joshajohnson/mini4wd-motor-tester/hardware/0.2/mini4wd-motor-tester.kicad_pcb

## KiCad design hardware/0.2/mini4wd-motor-tester.kicad_pcb (2026-05-05)

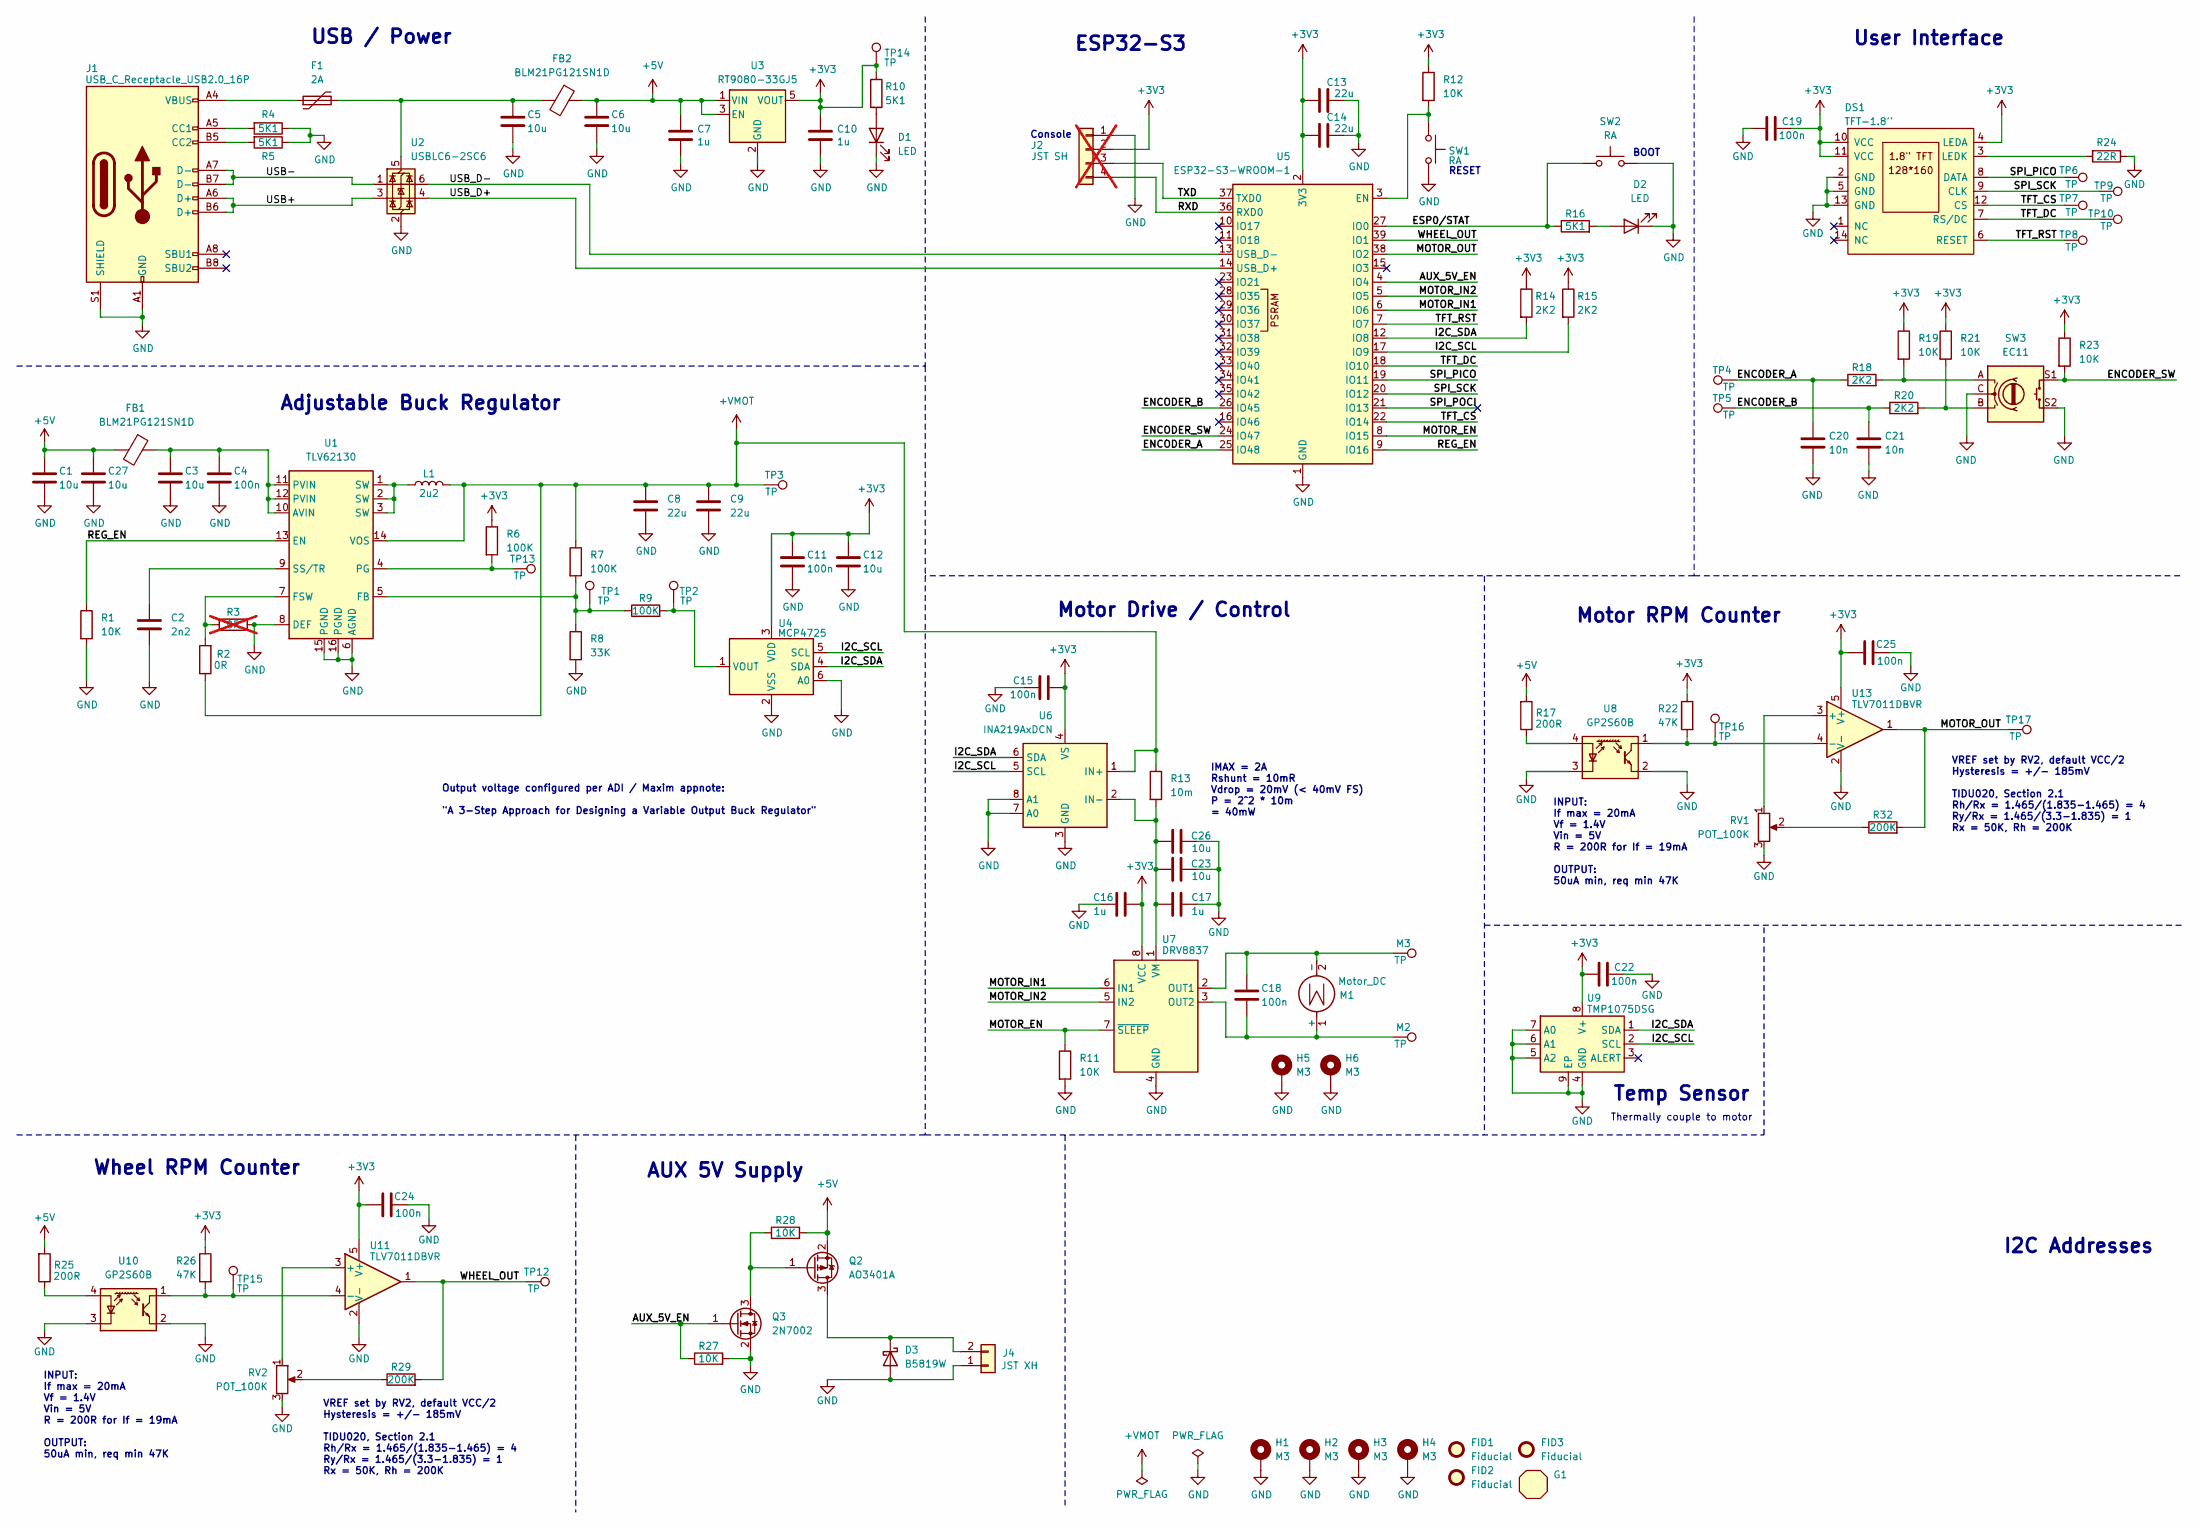
[picture p1: schematic mini4wd-motor-tester.kicad_sch, Mini4WD Motor Tester]

Parts:
C1, C3, C5, C6, C12, C23, C26, C27: 10u; C_0805_2012Metric; MPN GRM21BR61H106KE43L; LCSC C440198
C2: 2n2; C_0603_1608Metric; MPN 0603B222K500NT; LCSC C1604
C4, C11, C15, C18, C19, C22, C24, C25: 100n; C_0603_1608Metric; MPN CC0603KRX7R9BB104; LCSC C14663
C7, C10, C16, C17: 1u; C_0603_1608Metric; MPN CL10A105KB8NNNC; LCSC C15849
C8, C9, C13, C14: 22u; C_1206_3216Metric; MPN CL31A226KAHNNNE; LCSC C12891
C20, C21: 10n; C_0603_1608Metric; MPN 0603B103K500NT; LCSC C57112
D1, D2: LED; LED_0603_1608Metric; MPN KT-0603R; LCSC C2286
D3: B5819W; D_SOD-123; MPN B5819W SL; LCSC C8598
DS1: TFT-1.8''; 1.8TFT; MPN N177-1216TCWPG01-H14; LCSC C5123575
F1: 2A; Fuse_1206_3216Metric; MPN NANOSMDC200F-2; LCSC C2153712
FB1, FB2: BLM21PG121SN1D; L_0805_2012Metric; MPN BLM21PG121SN1D; LCSC C79382
FID1, FID2, FID3: Fiducial; Fiducial_1mm_Mask3mm
G1: josh-details
H1, H2, H3, H4, H5, H6: M3; MountingHole_3.2mm_M3_DIN965_Pad_TopBottom
J1: USB_C_Receptacle_USB2.0_16P; USB_C_Receptacle_HRO_TYPE-C-31-M-12; MPN TYPE-C-31-M-12; LCSC C165948
J2: JST SH; JST_SH_SM04B-SRSS-TB_1x04-1MP_P1.00mm_Horizontal; MPN SM04B-SRSS-TB(LF)(SN); LCSC C160404; not fitted
J4: JST XH; JST_XH_S2B-XH-A_1x02_P2.50mm_Horizontal; MPN S2B-XH-A(LF)(SN); LCSC C157931
L1: 2u2; L_Vishay_IHLP-1616; MPN PSPMAA0402-2R2M-ANP; LCSC C436515
M1: Motor_DC; Mini4WD_Motor
M2, M3: TP; TestPoint_THTPad_D1.5mm_Drill0.7mm
Q2: AO3401A; SOT-23; MPN AO3401A; LCSC C15127
Q3: 2N7002; SOT-23; MPN 2N7002; LCSC C8545
R1, R11, R12, R19, R21, R23, R27, R28: 10K; R_0603_1608Metric; MPN 0603WAF1002T5E; LCSC C25804
R2: 0R; R_0603_1608Metric; MPN 0603WAF0000T5E; LCSC C21189
R3: 0R; R_0603_1608Metric; MPN 0603WAF0000T5E; LCSC C21189; not fitted
R4, R5, R10, R16: 5K1; R_0603_1608Metric; MPN 0603WAF5101T5E; LCSC C23186
R6, R7, R9: 100K; R_0603_1608Metric; MPN 0603WAF1003T5E; LCSC C25803
R8: 33K; R_0603_1608Metric; MPN 0603WAF3302T5E; LCSC C4216
R13: 10m; R_1206_3216Metric; MPN CSR1206FT10L0; LCSC C346769
R14, R15, R18, R20: 2K2; R_0603_1608Metric; MPN 0603WAF2201T5E; LCSC C4190
R17, R25: 200R; R_0603_1608Metric; MPN 0603WAF2000T5E; LCSC C8218
R22, R26: 47K; R_0603_1608Metric; MPN 0603WAF4702T5E; LCSC C25819
R24: 22R; R_0603_1608Metric; MPN 0603WAF220JT5E; LCSC C23345
R29, R32: 200K; R_0603_1608Metric; MPN 0603WAF2003T5E; LCSC C25811
RV1, RV2: POT_100K; Potentiometer_Bourns_TC33X_Vertical; MPN TC33X-2-104E; LCSC C719186
SW1, SW2: RA; SW_PUSH_EVQPUL_EVQPUC; MPN TS-1186D-C-A; LCSC C397351
SW3: EC11; RotaryEncoder_Alps_EC11E_15MM; MPN PEC11R-4215F-S0024; LCSC C143790
TP1, TP2, TP3, TP4, TP5, TP6, TP7, TP8, TP9, TP10, TP12, TP13, TP14, TP15, TP16, TP17: TP; TestPoint_Pad_D1.0mm
U1: TLV62130; VQFN-16-1EP_3x3mm_P0.5mm_EP1.68x1.68mm; MPN TLV62130RGTR; LCSC C122479
U2: USBLC6-2SC6; SOT-23-6; MPN USBLC6-2SC6; LCSC C7519
U3: RT9080-33GJ5; SOT-23-5; MPN RT9080-33GJ5; LCSC C841192
U4: MCP4725; SOT-23-6; MPN MCP4725A0T-E/CH; LCSC C144198
U5: ESP32-S3-WROOM-1; MPN ESP32-S3-WROOM-1-N16R2; LCSC C2913205
U6: INA219AxDCN; SOT-23-8; MPN INA219AIDCNR; LCSC C87469
U7: DRV8837; WSON-8-1EP_2x2mm_P0.5mm_EP0.9x1.6mm; MPN DRV8837DSGR; LCSC C39159
U8, U10: GP2S60B; Sharp_GP2S60B; MPN GP2S60B; LCSC C83485
U9: TMP1075DSG; WSON-8-1EP_2x2mm_P0.5mm_EP0.9x1.6mm; MPN TMP1075DSGR; LCSC C2870250
U11, U13: TLV7011DBVR; SOT-23-5; MPN TLV7011DBVR; LCSC C702117

Connections:
+3V3: C10.2, C11.1, C12.1, C13.2, C14.2, C15.2, C16.1, C19.1, C22.2, C24.1, C25.1, DS1.4 (LEDA), DS1.10 (VCC), DS1.11 (VCC), J2.2, R6.1, R10.1, R12.1, R14.1, R15.1, R19.1, R21.1, R22.1, R23.1, R26.1, TP14.1, U3.5 (VOUT), U4.3 (VDD), U5.2 (3V3), U6.4 (VS), U7.8 (VCC), U9.8 (V+), U11.5 (V+), U13.5 (V+)
+5V: C1.1, C6.1, C7.2, C27.1, FB1.2, FB2.1, Q2.2 (S), R17.2, R25.2, R28.2, U3.1 (VIN), U3.3 (EN)
+VMOT: C8.1, C9.1, L1.2, R2.1, R7.1, R13.1, TP3.1, U1.14 (VOS), U6.1 (IN+)
/AUX_5V_EN: Q3.1 (G), R27.1, U5.4 (IO4)
/ENCODER_A: C20.1, R18.1, TP4.1, U5.25 (IO48)
/ENCODER_B: C21.1, R20.1, TP5.1, U5.26 (IO45)
/ENCODER_SW: R23.2, SW3.S1, U5.24 (IO47)
/ESP0/STAT: R16.1, SW2.1, U5.27 (IO0)
/I2C_SCL: R15.2, U4.5 (SCL), U5.17 (IO9), U6.5 (SCL), U9.2 (SCL)
/I2C_SDA: R14.2, U4.4 (SDA), U5.12 (IO8), U6.6 (SDA), U9.1 (SDA)
/MOTOR_EN: R11.1, U5.8 (IO15), U7.7 (~SLEEP)
/MOTOR_IN1: U5.6 (IO6), U7.6 (IN1)
/MOTOR_IN2: U5.5 (IO5), U7.5 (IN2)
/MOTOR_OUT: R32.2, TP17.1, U5.38 (IO2), U13.1
/REG_EN: R1.1, U1.13 (EN), U5.9 (IO16)
/RXD: J2.4, U5.36 (RXD0)
/SPI_PICO: DS1.8 (DATA), TP6.1, U5.19 (IO11)
/SPI_POCI: U5.21 (IO13)
/SPI_SCK: DS1.9 (CLK), TP9.1, U5.20 (IO12)
/TFT_CS: DS1.12 (CS), TP7.1, U5.22 (IO14)
/TFT_DC: DS1.7 (RS/DC), TP10.1, U5.18 (IO10)
/TFT_RST: DS1.6 (RESET), TP8.1, U5.7 (IO7)
/TXD: J2.3, U5.37 (TXD0)
/USB+: J1.A6 (D+), J1.B6 (D+), U2.3 (I/O2)
/USB-: J1.A7 (D-), J1.B7 (D-), U2.1 (I/O1)
/USB_D+: U2.4 (I/O2), U5.14 (USB_D+)
/USB_D-: U2.6 (I/O1), U5.13 (USB_D-)
/WHEEL_OUT: R29.2, TP12.1, U5.39 (IO1), U11.1
GND: C1.2, C2.2, C3.2, C4.2, C5.2, C6.2, C7.1, C8.2, C9.2, C10.1, C11.2, C12.2, C13.1, C14.1, C15.1, C16.2, C17.2, C19.2, C20.2, C21.2, C22.1, C23.2, C24.2, C25.2, C26.2, C27.2, D1.1 (K), D2.1 (K), D3.2 (A), DS1.2 (GND), DS1.5 (GND), DS1.13 (GND), H1.1, H2.1, H3.1, H4.1, H5.1, H6.1, J1.A1 (GND), J1.A12 (GND), J1.B1 (GND), J1.B12 (GND), J1.S1 (SHIELD), J2.1, J4.1, Q3.2 (S), R1.2, R3.2, R4.1, R5.1, R8.2, R11.2, R24.1, R27.2, RV1.3, RV2.3, SW1.2, SW2.2, SW3.C, SW3.S2, U1.6 (AGND), U1.8 (DEF), U1.15 (PGND), U1.16 (PGND), U1.17 (AGND), U2.2 (GND), U3.2 (GND), U4.2 (VSS), U4.6 (A0), U5.1 (GND), U5.40 (GND), U5.41 (GND), U6.3 (GND), U6.7 (A0), U6.8 (A1), U7.4 (GND), U7.9 (GND), U8.2, U8.3 (K), U9.4 (GND), U9.5 (A2), U9.6 (A1), U9.7 (A0), U9.9 (EP), U10.2, U10.3 (K), U11.2 (V-), U13.2 (V-)
unnamed: D1.2 (A), R10.2
unnamed: D2.2 (A), R16.2
unnamed: D3.1 (K), J4.2, Q2.3 (D)
unnamed: DS1.3 (LEDK), R24.2
unnamed: F1.1, J1.A4 (VBUS), J1.A9 (VBUS), J1.B4 (VBUS), J1.B9 (VBUS)
unnamed: J1.A5 (CC1), R4.2
unnamed: J1.B5 (CC2), R5.2
unnamed: L1.1, U1.1 (SW), U1.2 (SW), U1.3 (SW)
unnamed: C18.2, M1.1 (+), M2.1, U7.3 (OUT2)
unnamed: C18.1, M1.2 (-), M3.1, U7.2 (OUT1)
unnamed: Q2.1 (G), Q3.3 (D), R28.1
unnamed: R18.2, R19.2, SW3.A
unnamed: R20.2, R21.2, SW3.B
unnamed: R29.1, RV2.2
unnamed: R32.1, RV1.2
unnamed: C3.1, C4.1, FB1.1, U1.10 (AVIN), U1.11 (PVIN), U1.12 (PVIN)
unnamed: R7.2, R8.1, R9.1, TP1.1, U1.5 (FB)
unnamed: R2.2, R3.1, U1.7 (FSW)
unnamed: R6.2, TP13.1, U1.4 (PG)
unnamed: C2.1, U1.9 (SS/TR)
unnamed: C5.1, F1.2, FB2.2, U2.5 (VBUS)
unnamed: R9.2, TP2.1, U4.1 (VOUT)
unnamed: R12.2, SW1.1, U5.3 (EN)
unnamed: C17.1, C23.1, C26.1, R13.2, U6.2 (IN-), U7.1 (VM)
unnamed: R17.1, U8.4 (A)
unnamed: R25.1, U10.4 (A)
unnamed: RV2.1, U11.3 (+)
unnamed: R26.2, TP15.1, U10.1, U11.4 (-)
unnamed: RV1.1, U13.3 (+)
unnamed: R22.2, TP16.1, U8.1, U13.4 (-)

Notes on the sheet:
Thermally couple to motor
Console
Temp Sensor
BOOT
Wheel RPM Counter
AUX 5V Supply
Motor RPM Counter
Adjustable Buck Regulator
User Interface
RESET
USB / Power
I2C Addresses
Motor Drive / Control
ESP32-S3
VREF set by RV2, default VCC/2 Hysteresis = +/- 185mV TIDU020, Section 2.1 Rh/Rx = 1.465/(1.835-1.465) = 4 Ry/Rx = 1.465/(3.3-1.835) = 1 Rx = 50K, Rh = 200K
INPUT: If max = 20mA Vf = 1.4V Vin = 5V R = 200R for If = 19mA OUTPUT: 50uA min, req min 47K
Output voltage configured per ADI / Maxim appnote: "A 3-Step Approach for Designing a Variable Output Buck Regulator"
IMAX = 2A Rshunt = 10mR Vdrop = 20mV (< 40mV FS) P = 2^2 * 10m = 40mW

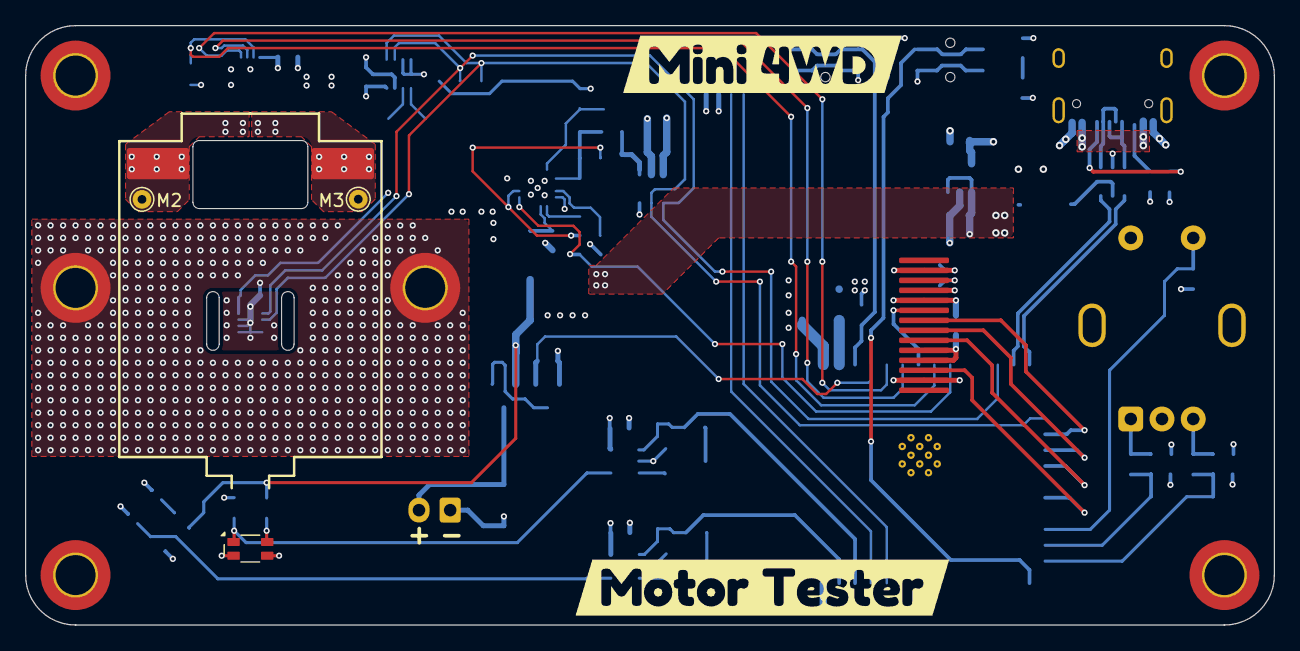
[picture p2: board mini4wd-motor-tester.kicad_pcb from above]

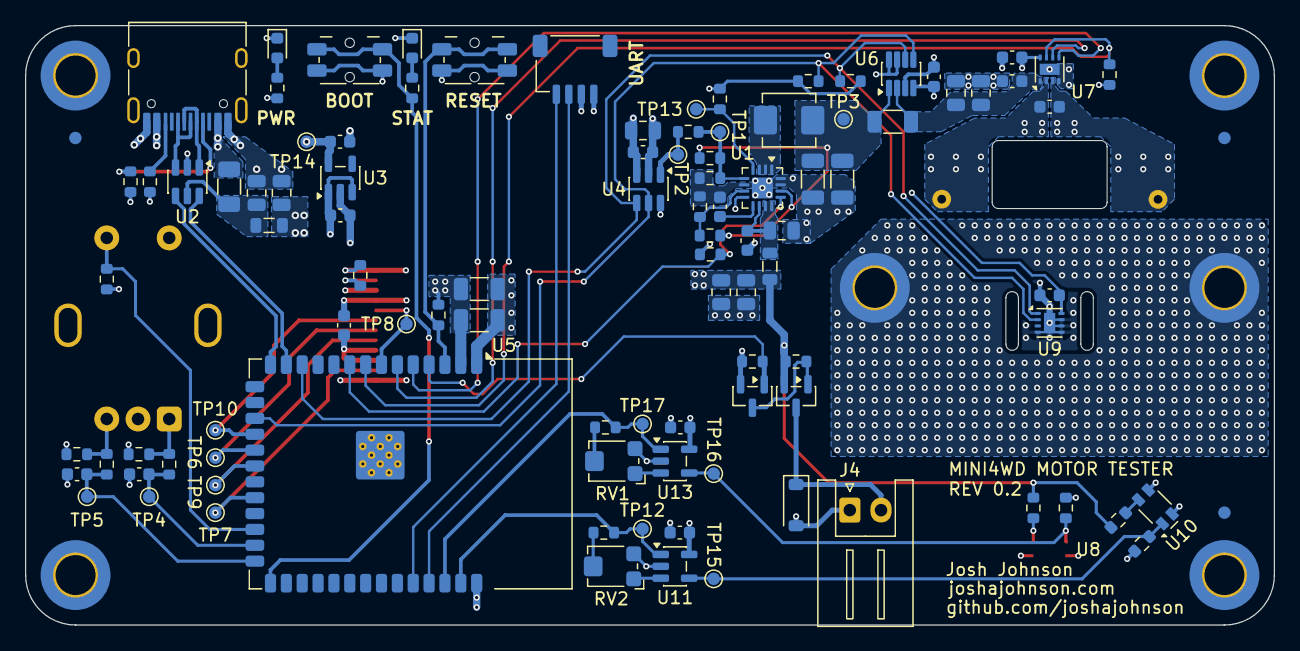
[picture p3: board mini4wd-motor-tester.kicad_pcb from below]

Board: 4 copper layers, 100.0 x 48.0 mm, 118 parts (104 on the bottom side), 58 nets.

Other parts of the board:
kibuzzard-697CCA76: G***; kibuzzard-697CCA76
kibuzzard-697CCA92: G***; kibuzzard-697CCA92
