joshajohnson/mini4wd-motor-tester/firmware/src/rotary_irq_esp.py

# MIT License (MIT)
# Copyright (c) 2020 Mike Teachman
# https://opensource.org/licenses/MIT

# Platform-specific MicroPython code for the rotary encoder module
# ESP8266/ESP32 implementation

# Documentation:
#   https://github.com/MikeTeachman/micropython-rotary

from machine import Pin
from rotary import Rotary
from sys import platform


class RotaryIRQ(Rotary):
    """
    MicroPython Driver for rotary encoders.

    Example:

        r = rotary_irq_esp.RotaryIRQ()

        val_old = r.value()
        while True:
            val_new = r.value()

            if val_old != val_new:
                val_old = val_new
                print('result =', val_new)

            time.sleep_ms(50)

    """

    def __init__(
        self,
        pin_num_clk: int = None,
        pin_num_dt: int = None,
        min_val: int = 0,
        max_val: int = 10,
        incr: int = 1,
        reverse: bool = False,
        range_mode: int = Rotary.RANGE_UNBOUNDED,
        pull_up: bool = False,
        half_step: bool = False,
        invert: bool = False,
    ):

        super().__init__(min_val, max_val, incr, reverse, range_mode, half_step, invert)

        if pull_up is True:
            self._pin_clk = Pin(pin_num_clk, Pin.IN, Pin.PULL_UP)
            self._pin_dt = Pin(pin_num_dt, Pin.IN, Pin.PULL_UP)
        else:
            self._pin_clk = Pin(pin_num_clk, Pin.IN)
            self._pin_dt = Pin(pin_num_dt, Pin.IN)

        self._enable_clk_irq(self._process_rotary_pins)
        self._enable_dt_irq(self._process_rotary_pins)

    def _enable_clk_irq(self, callback=None):
        self._pin_clk.irq(trigger=Pin.IRQ_RISING | Pin.IRQ_FALLING, handler=callback)

    def _enable_dt_irq(self, callback=None):
        self._pin_dt.irq(trigger=Pin.IRQ_RISING | Pin.IRQ_FALLING, handler=callback)

    def _disable_clk_irq(self):
        self._pin_clk.irq(handler=None)

    def _disable_dt_irq(self):
        self._pin_dt.irq(handler=None)

    def _hal_get_clk_value(self):
        return self._pin_clk.value()

    def _hal_get_dt_value(self):
        return self._pin_dt.value()

    def _hal_enable_irq(self):
        self._enable_clk_irq(self._process_rotary_pins)
        self._enable_dt_irq(self._process_rotary_pins)

    def _hal_disable_irq(self):
        self._disable_clk_irq()
        self._disable_dt_irq()

    def _hal_close(self):
        self._hal_disable_irq()
