joshajohnson/mini4wd-motor-tester/(commit log)

2026-01-27 initial commit after importing old template project
    [mini4x4-motor-tester.kicad_pcb, mini4x4-motor-tester.kicad_sch]
2026-01-27 sch done, all parts in pcb
    [mini4wd-motor-tester.kicad_pcb, mini4wd-motor-tester.kicad_sch, mini4x4-motor-tester.kicad_pcb, mini4x4-motor-tester.kicad_sch]
2026-01-27 rough component placement
    [mini4wd-motor-tester.kicad_pcb]
2026-01-27 add wheel rpm, aux 5V circuits
    [mini4wd-motor-tester.kicad_pcb, mini4wd-motor-tester.kicad_sch]
2026-01-27 update motor cutout, provision space for wheel speed tester
    [mini4wd-motor-tester.kicad_pcb, mini4wd-motor-tester.kicad_sch]
2026-01-28 shrinking board down
    [mini4wd-motor-tester.kicad_pcb, mini4wd-motor-tester.kicad_sch]
2026-01-28 rough placement of all parts on smaller board
    [mini4wd-motor-tester.kicad_pcb, mini4wd-motor-tester.kicad_sch]
2026-01-28 I think the final form has been reached?
    [mini4wd-motor-tester.kicad_pcb, mini4wd-motor-tester.kicad_sch]
2026-01-28 move encoder passives in from the edge
    [mini4wd-motor-tester.kicad_pcb]
2026-01-28 cutouts under the motor
    [mini4wd-motor-tester.kicad_pcb]
2026-01-30 change opto, move motor lower
    [mini4wd-motor-tester.kicad_pcb, mini4wd-motor-tester.kicad_sch]
2026-01-31 board passing erc and drc
    [mini4wd-motor-tester.kicad_pcb, mini4wd-motor-tester.kicad_sch]
2026-02-01 off to fab
    [mini4wd-motor-tester.kicad_pcb, mini4wd-motor-tester.kicad_sch]
2026-02-25 add 0.1 heatsink files
    [motor-heatsink.kicad_pcb, motor-heatsink.kicad_sch]
2026-02-25 add temp sensor driver, update main to i2c detect then loop update temp
2026-02-25 improve tmp1075 driver, change i2cdetect formatting
2026-02-26 add ina219, mcp4725 drivers, write psu functions, check and calibrate dac / imon loop
2026-02-27 add rotary encoder, button, motor control. refactor lvgl display code. delete test code folder
2026-02-28 add averaging to current monitor, remove coast from motor control
2026-03-07 add motor state change logic, voltage ramping, average current measurement
2026-04-26 fix footprints
2026-04-26 wip r0.2
    [mini4wd-motor-tester.kicad_pcb, mini4wd-motor-tester.kicad_sch]
2026-05-03 add v2 heatsink, improve layout for v2 main
    [mini4wd-motor-tester.kicad_pcb, mini4wd-motor-tester.kicad_sch, motor-heatsink.kicad_pcb, motor-heatsink.kicad_sch]
2026-05-03 minor sch and pcb updates
    [mini4wd-motor-tester.kicad_pcb, mini4wd-motor-tester.kicad_sch]
